EE4737-TeamCatapult-Spring2026/PowerSlice/README.md

# PowerSlice
The slice that does the power stuff
