EE4737-TeamCatapult-Spring2026/PowerSlice/Board Files/NUCLEO_F303K8/NUCLEO-F303K8.step

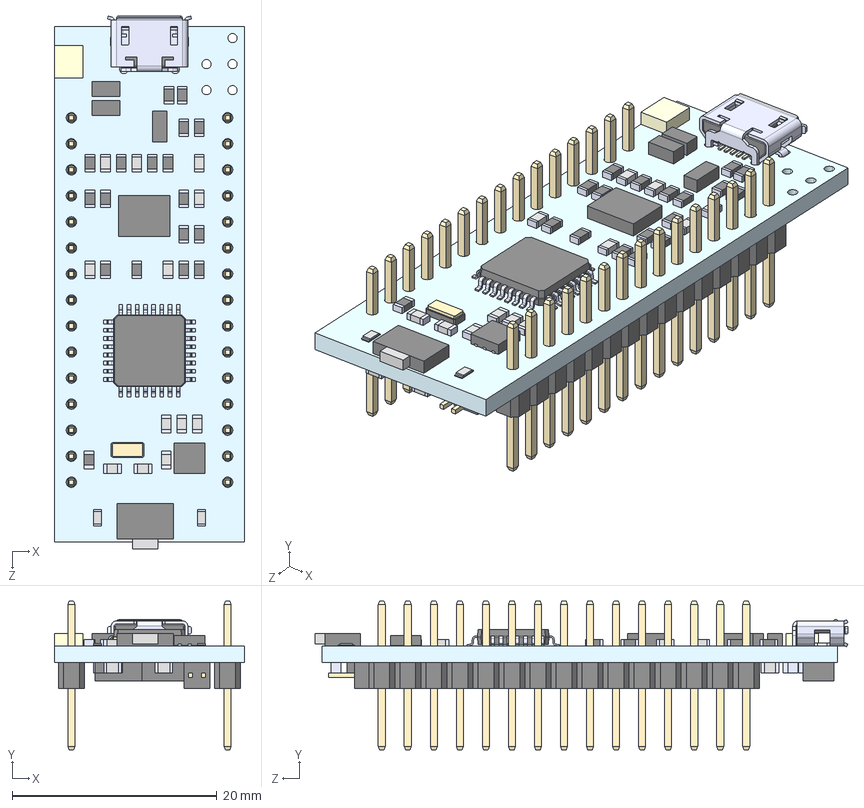
[picture p1: CAD file, 2026-03-17]
Board Files/NUCLEO_F303K8/NUCLEO-F303K8.step
18.5 x 14.5 x 52.0 mm
mb1180c
LD39050PU33R-Nucleo
STM32F103CBT6-nucleo
header x2
lqpf1
