EE4737-TeamCatapult-Spring2026/PowerSlice/Board Files/691137710002/691137710002.step

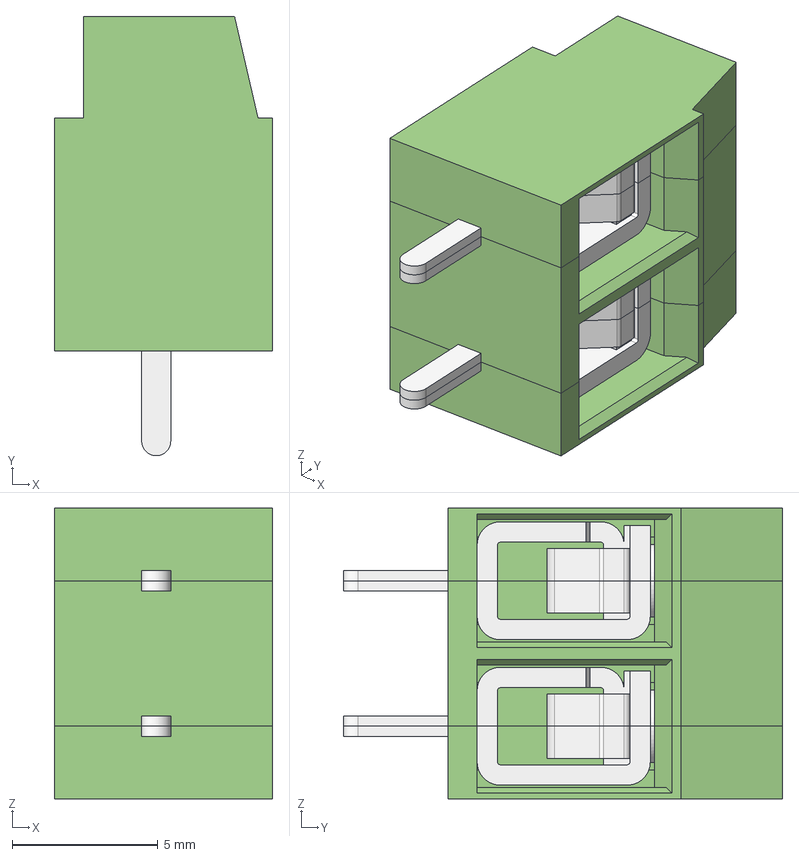
[picture p2: CAD file, 2026-02-17]
Board Files/691137710002/691137710002.step
7.50 x 15.1 x 10.0 mm
MRT12P5_SX
MRT12P5_CNT
MRT12P5_DX
