EE4737-TeamCatapult-Spring2026/PowerSlice/Board Files/PowerSlice.kicad_pcb

## KiCad design Board Files/PowerSlice.kicad_pcb (2026-04-10)

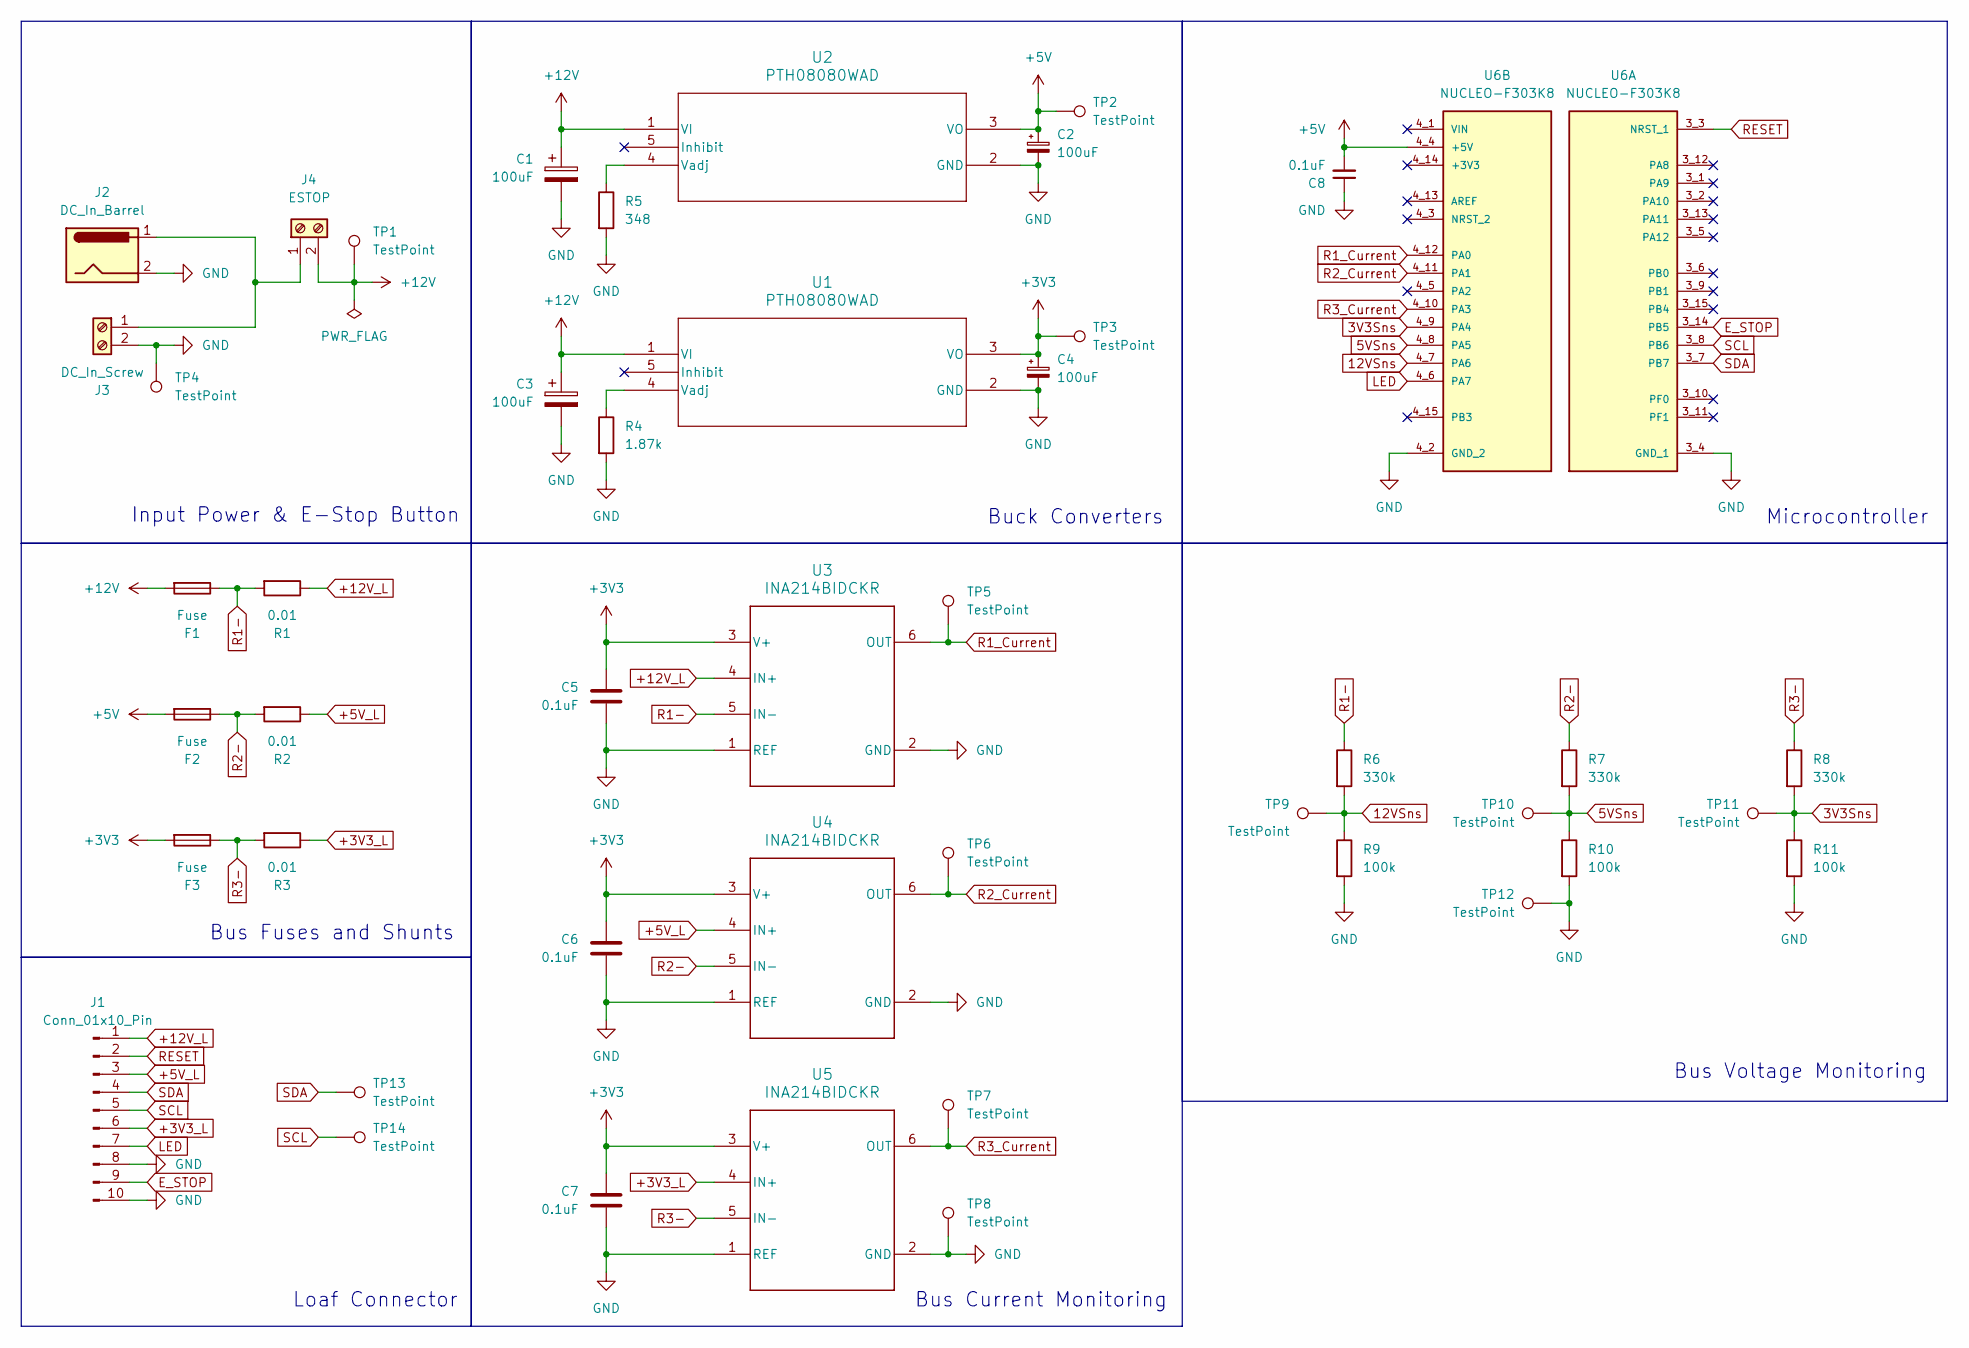
[picture p3: schematic PowerSlice.kicad_sch]

Parts:
C1, C2, C3, C4: 100uF; CP_Radial_D6.3mm_P2.50mm
C5, C6, C7, C8: 0.1uF; C_1206_3216Metric_Pad1.33x1.80mm_HandSolder
F1, F2, F3: Fuse; FUSE_354 101-GY_LTF
J1: Conn_01x10_Pin; PinHeader_1x10_P2.54mm_Horizontal
J2: DC_In_Barrel
J3: DC_In_Screw; 691137710002
J4: ESTOP; 691137710002
R1, R2, R3: 0.01; R_1206_3216Metric_Pad1.30x1.75mm_HandSolder
R4: 1.87k; R_1206_3216Metric_Pad1.30x1.75mm_HandSolder
R5: 348; R_1206_3216Metric_Pad1.30x1.75mm_HandSolder
R6, R7, R8: 330k; R_1206_3216Metric_Pad1.30x1.75mm_HandSolder
R9, R10, R11: 100k; R_1206_3216Metric_Pad1.30x1.75mm_HandSolder
TP1, TP2, TP3, TP4, TP5, TP6, TP7, TP8, TP9, TP10, TP11, TP12, TP13, TP14: TestPoint; TestPoint_Keystone_5005-5009_Compact
U1, U2: PTH08080WAD; EUF5
U3, U4, U5: INA214BIDCKR; DCK0006A_N
U6: NUCLEO-F303K8; MODULE_NUCLEO-F303K8; PARTREV 5

Connections:
3V3Sns: R8.2, R11.1, TP11.1 (1_1), U6.4_9 (PA4)
5VSns: R7.2, R10.1, TP10.1 (1_1), U6.4_8 (PA5)
12VSns: R6.2, R9.1, TP9.1 (1_1), U6.4_7 (PA6)
+3V3: C4.1, C5.1, C6.1, C7.1, F3.2, TP3.1 (1_1), U1.3 (VO), U3.3 (V+), U4.3 (V+), U5.3 (V+)
+3V3_L: J1.6, R3.1, U5.4 (IN+)
+5V: C2.1, C8.2, F2.2, TP2.1 (1_1), U2.3 (VO), U6.4_4 (+5V)
+5V_L: J1.3, R2.1, U4.4 (IN+)
+12V: C1.1, C3.1, F1.2, J4.2, TP1.1 (1_1), U1.1 (VI), U2.1 (VI)
+12V_L: J1.1, R1.1, U3.4 (IN+)
E_STOP: J1.9, U6.3_14 (PB5)
GND: C1.2, C2.2, C3.2, C4.2, C5.2, C6.2, C7.2, C8.1, J1.8, J1.10, J2.2, J3.2, R4.2, R5.2, R9.2, R10.2, R11.2, TP4.1 (1_1), TP8.1 (1_1), TP12.1 (1_1), U1.2 (GND), U2.2 (GND), U3.1 (REF), U3.2 (GND), U4.1 (REF), U4.2 (GND), U5.1 (REF), U5.2 (GND), U6.3_4 (GND_1), U6.4_2 (GND_2)
LED: J1.7, U6.4_6 (PA7)
unnamed: J2.1, J3.1, J4.1
unnamed: R4.1, U1.4 (Vadj)
unnamed: R5.1, U2.4 (Vadj)
R1-: F1.1, R1.2, R6.1, U3.5 (IN-)
R1_Current: TP5.1 (1_1), U3.6 (OUT), U6.4_12 (PA0)
R2-: F2.1, R2.2, R7.1, U4.5 (IN-)
R2_Current: TP6.1 (1_1), U4.6 (OUT), U6.4_11 (PA1)
R3-: F3.1, R3.2, R8.1, U5.5 (IN-)
R3_Current: TP7.1 (1_1), U5.6 (OUT), U6.4_10 (PA3)
RESET: J1.2, U6.3_3 (NRST_1)
SCL: J1.5, TP14.1 (1_1), U6.3_8 (PB6)
SDA: J1.4, TP13.1 (1_1), U6.3_7 (PB7)

Notes on the sheet:
Microcontroller
Bus Fuses and Shunts
Input Power & E-Stop Button
Bus Voltage Monitoring
Bus Current Monitoring
Loaf Connector
Buck Converters

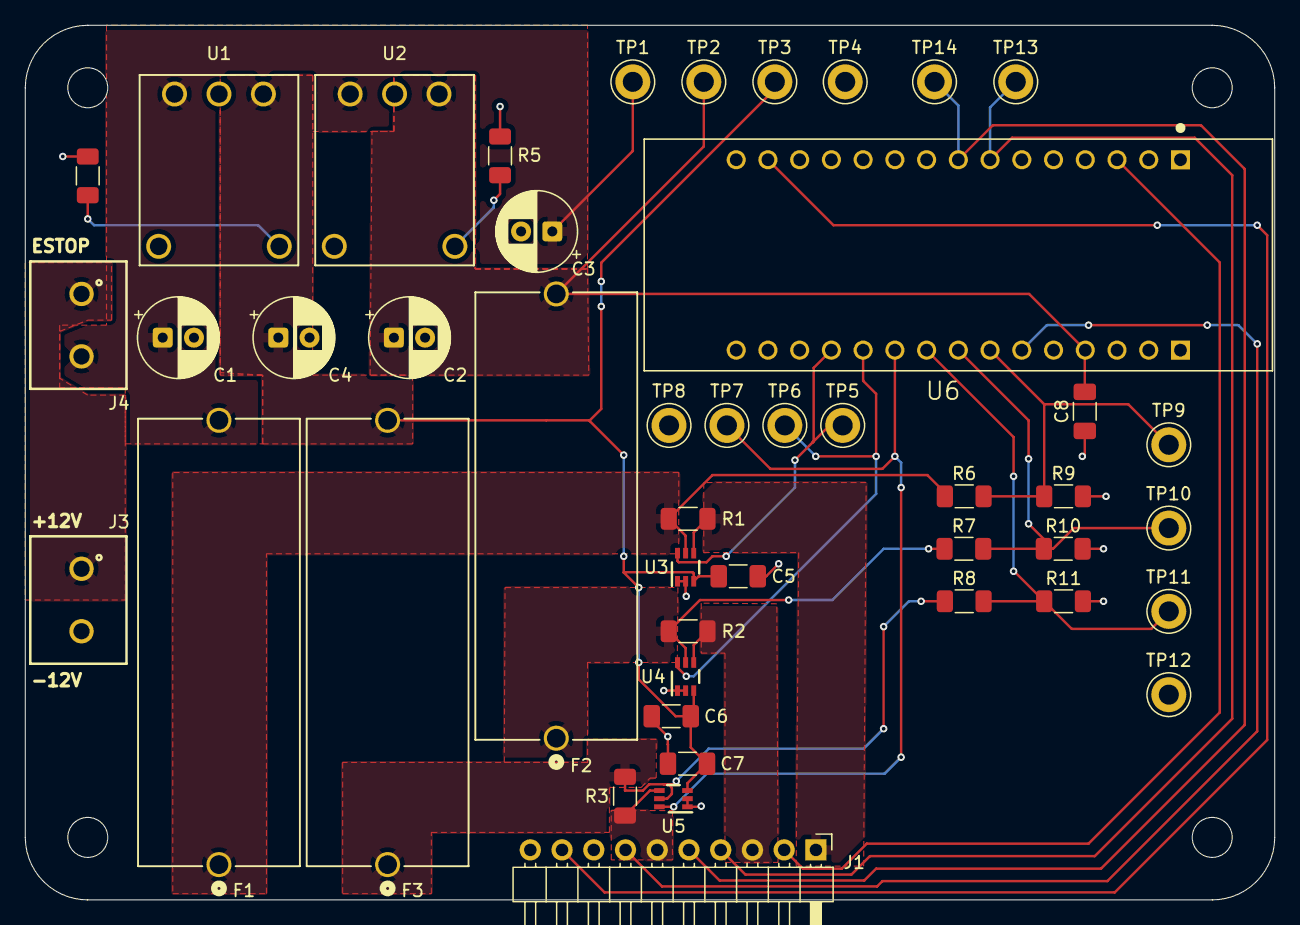
[picture p4: board PowerSlice.kicad_pcb from above]

Board: 2 copper layers, 100.0 x 70.0 mm, 45 parts (0 on the bottom side), 24 nets.
