EE4737-TeamCatapult-Spring2026/PowerSlice/Firmware/Core/Src/main.c

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
/* Includes ------------------------------------------------------------------*/
#include "main.h"

/* USER CODE BEGIN Includes */
#include <string.h>
#include <stdio.h>
/* USER CODE END Includes */

/* USER CODE BEGIN PTD */
struct current_data
{
  uint32_t current12V;
  uint32_t current5V;
  uint32_t current3V3;
  uint8_t status;
  uint32_t count3V3;
  uint32_t count5V;
  uint32_t count12V;
};
/* USER CODE END PTD */

/* USER CODE BEGIN PD */
#define STATUS_OK 0x1
#define STATUS_BUSY	0x2
#define STATUS_ERROR 0x3
#define MASTER_ADDR 0x00 << 1
#define SLAVE_ADDR 0x40 << 1
#define POLL_TIME 100
/* USER CODE END PD */

ADC_HandleTypeDef hadc1;
ADC_HandleTypeDef hadc2;

I2C_HandleTypeDef hi2c1;

TIM_HandleTypeDef htim1;

/* USER CODE BEGIN PV */
uint8_t rxData[1] = {0x0};
uint8_t txData[4] = {0x0, 0x0, 0x0, 0x0};
uint8_t txLen = 0;
uint8_t commandReady = 0;
int32_t voltage3V3 = 0;
int32_t voltage5V = 0;
int32_t voltage12V = 0;
struct current_data sensor_data;
/* USER CODE END PV */

void SystemClock_Config(void);
static void MX_GPIO_Init(void);
static void MX_ADC1_Init(void);
static void MX_ADC2_Init(void);
static void MX_I2C1_Init(void);
static void MX_TIM1_Init(void);
/* USER CODE BEGIN 0 */
int32_t ADC_to_mA(int32_t val)
  {
	  return ((-805*val)/1000) + 3298;
  }

uint16_t ADC_Convert_3V3(void)
  {
    /* Configure channel */
    ADC_ChannelConfTypeDef sConfig = {0};
    sConfig.Channel = ADC_CHANNEL_1;
    sConfig.Rank = ADC_REGULAR_RANK_1;
    if (HAL_ADC_ConfigChannel(&hadc2, &sConfig) != HAL_OK)
    {
      Error_Handler();
    }

    /* Convert the Channel */
    HAL_ADC_Start(&hadc2);
    HAL_ADC_PollForConversion(&hadc2, POLL_TIME);
    uint16_t adcval = HAL_ADC_GetValue(&hadc2);
    HAL_ADC_Stop(&hadc2);
    return adcval;
  }

  uint16_t ADC_Convert_5V(void)
  {
    /* Configure channel */
    ADC_ChannelConfTypeDef sConfig = {0};
    sConfig.Channel = ADC_CHANNEL_2;
    sConfig.Rank = ADC_REGULAR_RANK_1;
    if (HAL_ADC_ConfigChannel(&hadc2, &sConfig) != HAL_OK)
    {
      Error_Handler();
    }

    /* Convert the Channel */
    HAL_ADC_Start(&hadc2);
    HAL_ADC_PollForConversion(&hadc2, POLL_TIME);
    uint16_t adcval = HAL_ADC_GetValue(&hadc2);
    HAL_ADC_Stop(&hadc2);
    return adcval;
  }

  uint16_t ADC_Convert_12V(void)
  {
    /* Configure channel */
    ADC_ChannelConfTypeDef sConfig = {0};
    sConfig.Channel = ADC_CHANNEL_3;
    sConfig.Rank = ADC_REGULAR_RANK_1;
    if (HAL_ADC_ConfigChannel(&hadc2, &sConfig) != HAL_OK)
    {
      Error_Handler();
    }

    /* Convert the Channel */
    HAL_ADC_Start(&hadc2);
    HAL_ADC_PollForConversion(&hadc2, POLL_TIME);
    uint16_t adcval = HAL_ADC_GetValue(&hadc2);
    HAL_ADC_Stop(&hadc2);
    return adcval;
  }

  uint16_t ADC_Convert_3V3_Current(void)
  {
    /* Configure channel */
    ADC_ChannelConfTypeDef sConfig = {0};
    sConfig.Channel = ADC_CHANNEL_4;
    sConfig.Rank = ADC_REGULAR_RANK_1;
    if (HAL_ADC_ConfigChannel(&hadc1, &sConfig) != HAL_OK)
    {
      Error_Handler();
    }

    /* Convert the Channel */
    HAL_ADC_Start(&hadc1);
    HAL_ADC_PollForConversion(&hadc1, POLL_TIME);
    uint16_t adcval = HAL_ADC_GetValue(&hadc1);
    HAL_ADC_Stop(&hadc1);
    return ADC_to_mA(adcval);
  }

  uint16_t ADC_Convert_5V_Current(void)
  {
    /* Configure channel */
    ADC_ChannelConfTypeDef sConfig = {0};
    sConfig.Channel = ADC_CHANNEL_2;
    sConfig.Rank = ADC_REGULAR_RANK_1;
    if (HAL_ADC_ConfigChannel(&hadc1, &sConfig) != HAL_OK)
    {
      Error_Handler();
    }

    /* Convert the Channel */
    HAL_ADC_Start(&hadc1);
    HAL_ADC_PollForConversion(&hadc1, POLL_TIME);
    uint16_t adcval = HAL_ADC_GetValue(&hadc1);
    HAL_ADC_Stop(&hadc1);
    return ADC_to_mA(adcval);
  }

  uint16_t ADC_Convert_12V_Current(void)
  {
    /* Configure channel */
    ADC_ChannelConfTypeDef sConfig = {0};
    sConfig.Channel = ADC_CHANNEL_1;
    sConfig.Rank = ADC_REGULAR_RANK_1;
    if (HAL_ADC_ConfigChannel(&hadc1, &sConfig) != HAL_OK)
    {
      Error_Handler();
    }

    /* Convert the Channel */
    HAL_ADC_Start(&hadc1);
    HAL_ADC_PollForConversion(&hadc1, POLL_TIME);
    uint16_t adcval = HAL_ADC_GetValue(&hadc1);
    HAL_ADC_Stop(&hadc1);
    return ADC_to_mA(adcval);
  }

/* USER CODE END 0 */

/**
  * @brief  The application entry point.
  * @retval int
  */
int main(void)
{

  /* MCU Configuration--------------------------------------------------------*/

  /* Reset of all peripherals, Initializes the Flash interface and the Systick. */
  HAL_Init();

  /* Configure the system clock */
  SystemClock_Config();

  /* Initialize all configured peripherals */
  MX_GPIO_Init();
  MX_ADC1_Init();
  MX_ADC2_Init();
  MX_I2C1_Init();
  MX_TIM1_Init();
  /* USER CODE BEGIN 2 */
  HAL_I2C_Slave_Receive_IT(&hi2c1, rxData, 1);
  /* USER CODE END 2 */

  /* Infinite loop */
  /* USER CODE BEGIN WHILE */
  while (1)
  {
	  voltage12V = ADC_Convert_12V();
	  voltage5V = ADC_Convert_5V();
	  voltage3V3 = ADC_Convert_3V3();
	  sensor_data.current12V += ADC_Convert_12V_Current();
	  sensor_data.count12V++;
	  sensor_data.current5V += ADC_Convert_5V_Current();
	  sensor_data.count5V++;
	  sensor_data.current3V3 += ADC_Convert_3V3_Current();
	  sensor_data.count3V3++;
	  HAL_Delay(POLL_TIME);
    /* USER CODE END WHILE */

    /* USER CODE BEGIN 3 */
  }
  /* USER CODE END 3 */
}

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
/* USER CODE BEGIN 4 */
void HAL_I2C_SlaveRxCpltCallback(I2C_HandleTypeDef *hi2c)
{
	switch (rxData[0])
	{
		case 0x01:	// Loaf is requesting status
			if (voltage12V < 500 || voltage5V < 500 || voltage3V3 < 500)
			{
				sensor_data.status = STATUS_ERROR;
			}
			else
			{
				sensor_data.status = STATUS_OK;
			}
			txData[0] = sensor_data.status;
			txLen = 1;
			break;

		case 0x02:	// Loaf is requesting 3V3 current draw
			if(sensor_data.count3V3 == 0)
			{
				txData[0] = 69;
				txData[1] = 0;
				txData[2] = 0;
				txData[3] = 0;
				HAL_I2C_Slave_Transmit_IT(hi2c, txData, txLen);
				return;
			}

			sensor_data.current3V3 /= sensor_data.count3V3;
			txData[0] = (sensor_data.current3V3 >> 0) & 0xFF;
			txData[1] = (sensor_data.current3V3 >> 8) & 0xFF;
			txData[2] = (sensor_data.current3V3 >> 16) & 0xFF;
			txData[3] = (sensor_data.current3V3 >> 24) & 0xFF;
			txLen = 4;
			sensor_data.current3V3 = 0;		// Reset values
			sensor_data.count3V3 = 0;
			break;

		case 0x03:	// Loaf is requesting 5V current draw
			if(sensor_data.count5V == 0)
			{
				txData[0] = 69;
				txData[1] = 0;
				txData[2] = 0;
				txData[3] = 0;
				HAL_I2C_Slave_Transmit_IT(hi2c, txData, txLen);
				return;
			}

			sensor_data.current5V /= sensor_data.count5V;
			txData[0] = (sensor_data.current5V >> 0) & 0xFF;
			txData[1] = (sensor_data.current5V >> 8) & 0xFF;
			txData[2] = (sensor_data.current5V >> 16) & 0xFF;
			txData[3] = (sensor_data.current5V >> 24) & 0xFF;
			txLen = 4;
			sensor_data.current5V = 0;		// Reset values
			sensor_data.count5V = 0;
			break;

		case 0x04:	// Loaf is requesting 12V current draw
			if(sensor_data.count12V == 0)
			{
				txData[0] = 69;
				txData[1] = 0;
				txData[2] = 0;
				txData[3] = 0;
				HAL_I2C_Slave_Transmit_IT(hi2c, txData, txLen);
				return;
			}

			sensor_data.current12V /= sensor_data.count12V;
			txData[0] = (sensor_data.current12V >> 0) & 0xFF;
			txData[1] = (sensor_data.current12V >> 8) & 0xFF;
			txData[2] = (sensor_data.current12V >> 16) & 0xFF;
			txData[3] = (sensor_data.current12V >> 24) & 0xFF;
			txLen = 4;
			sensor_data.current12V = 0;		// Reset values
			sensor_data.count12V = 0;
			break;

		default:
			return; // Command unsupported
	}
	HAL_I2C_Slave_Transmit_IT(hi2c, txData, txLen);
}

void HAL_I2C_SlaveTxCpltCallback(I2C_HandleTypeDef *hi2c)
{
	HAL_I2C_Slave_Receive_IT(hi2c, rxData, 1);
}

/* USER CODE END 4 */
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
