EE4737-TeamCatapult-Spring2026/PowerSlice/Firmware/PowerSlice.ioc

Mcu.UserName=STM32F303K8Tx
PA0.Signal=ADC1_IN1
PA1.Signal=ADC1_IN2
PA13.GPIO_Label=SWDIO
PA13.Signal=SYS_JTMS-SWDIO
PA14.GPIO_Label=SWCLK
PA14.Signal=SYS_JTCK-SWCLK
PA3.Signal=ADC1_IN4
PA4.Signal=ADC2_IN1
PA5.Signal=ADC2_IN2
PA6.Signal=ADC2_IN3
PA7.Signal=GPIO_Output
PB5.Signal=GPXTI5
PB6.Signal=I2C1_SCL
PB7.Signal=I2C1_SDA
