EE4737-TeamCatapult-Spring2026/PowerSlice/Firmware/Core/Inc/main.h

#define MCO_Pin GPIO_PIN_0
#define MCO_GPIO_Port GPIOF
#define SWDIO_Pin GPIO_PIN_13
#define SWDIO_GPIO_Port GPIOA
#define SWCLK_Pin GPIO_PIN_14
#define SWCLK_GPIO_Port GPIOA
