EE4737-TeamCatapult-Spring2026/PowerSlice/(commit log)

2026-01-21 started schematic work on power slice. TODO: MCU connections, loaf voltage dividers to measure loaf voltages safely on mcu
    [PowerSlice.kicad_pcb, PowerSlice.kicad_sch]
2026-01-27 finished preliminary schematic
    [PowerSlice.kicad_sch]
2026-01-27 fixed all ERC warnings/errors
    [PowerSlice.kicad_sch]
2026-02-09 updated some small pieces, namely estop is changed from a button symbol to a screw terminal for external connection
    [PowerSlice.kicad_sch]
2026-02-17 Updated schematic + built PCB
    [691137710002.step, PowerSlice.kicad_pcb, PowerSlice.kicad_sch]
2026-02-17 updated lightly after PCB review TODO: figure out LED and Header pins
    [PowerSlice.kicad_pcb, PowerSlice.kicad_sch]
2026-02-24 Wacky stuff that needs to be changed cuz it wont work and will be reverted
    [PowerSlice.kicad_pcb, PowerSlice.kicad_sch]
2026-02-24 Work, TODO: figure out external power connectors
    [PowerSlice.kicad_pcb, PowerSlice.kicad_sch]
2026-02-25 "Final" edits before submission for ordering
    [PowerSlice-B_Cu.gbr, PowerSlice-B_Mask.gbr, PowerSlice-B_Paste.gbr, PowerSlice-B_Silkscreen.gbr, PowerSlice-Edge_Cuts.gbr, PowerSlice-F_Cu.gbr, PowerSlice-F_Mask.gbr, PowerSlice-F_Paste.gbr]
2026-03-17 Adding Firmware folder + renamed board files folder
    [691137710002.step, NUCLEO-F303K8.step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]
2026-03-17 Setup base stm32 project
2026-03-24 Lab 11 Progress
    Added DMA ADC requests to process current data, starting to set up conditions for I2C communication
2026-04-07 Fixed voltage ADC reading problem :)
    ADCs work now, need to work on current sensing validation + I2C packet communication (ez)
    [PowerSlice.ioc, main.c]
2026-04-10 updated gitignore for KiCad 10
2026-04-10 Updated to KiCAD 10, fancified schematic for final presentation, verified ERC and DRC still good
    [PowerSlice.kicad_pcb, PowerSlice.kicad_sch]
2026-04-16 Updated I2C code
2026-04-20 I2C WORKING
    yayayayayay
